BiaginiMatheus/usb-ups-simulator/(commit log)

2026-09-19 UPS code to make the arduino act as a UPS + instructions on how to do it
2026-09-23 Adding circuit diagram and final details
